MovindiM/Lead-Acid-Battery-Charger/Lead_Acid_Battery_Charger_PCB/Constant_Current/Schematic_Constant-Current_2022-05-03.png

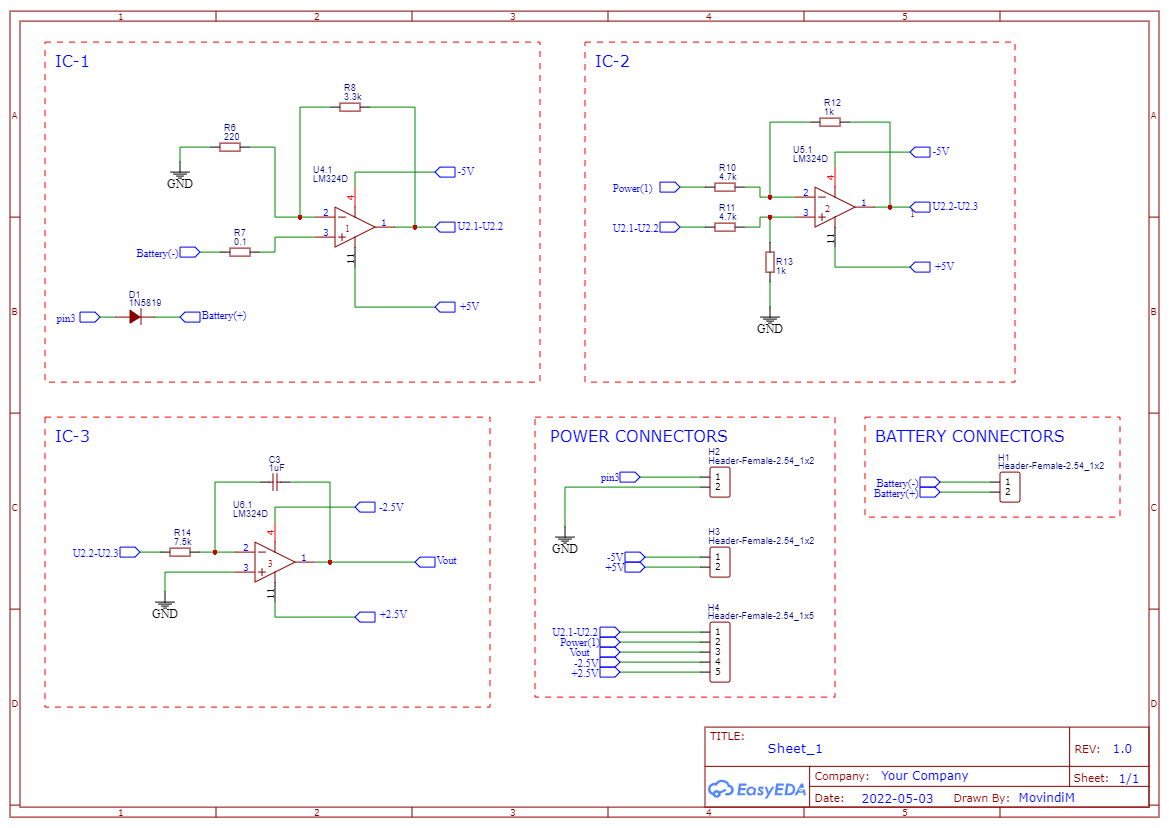
Lead_Acid_Battery_Charger_PCB/Constant_Current/Schematic_Constant-Current_2022-05-03.png
