MovindiM/Lead-Acid-Battery-Charger/Lead_Acid_Battery_Charger_PCB/Constant_Volatage/PCB_PCB_Constant-Voltage_2022-05-03.png

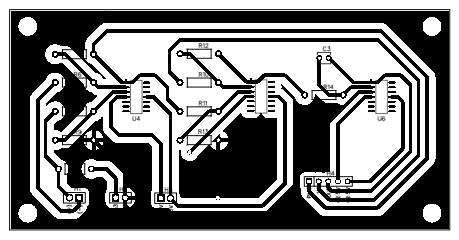
Lead_Acid_Battery_Charger_PCB/Constant_Volatage/PCB_PCB_Constant-Voltage_2022-05-03.png
