MovindiM/Lead-Acid-Battery-Charger/Lead_Acid_Battery_Charger_PCB/PWM/PCB_PCB_PWM_2022-05-03.png

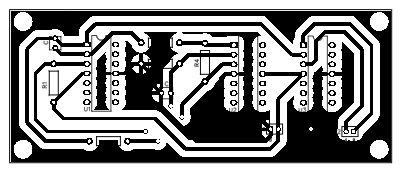
Lead_Acid_Battery_Charger_PCB/PWM/PCB_PCB_PWM_2022-05-03.png
