MovindiM/Lead-Acid-Battery-Charger/Lead_Acid_Battery_Charger_PCB/PWM/Schematic_Semester4-Lab project_2022-05-03.png

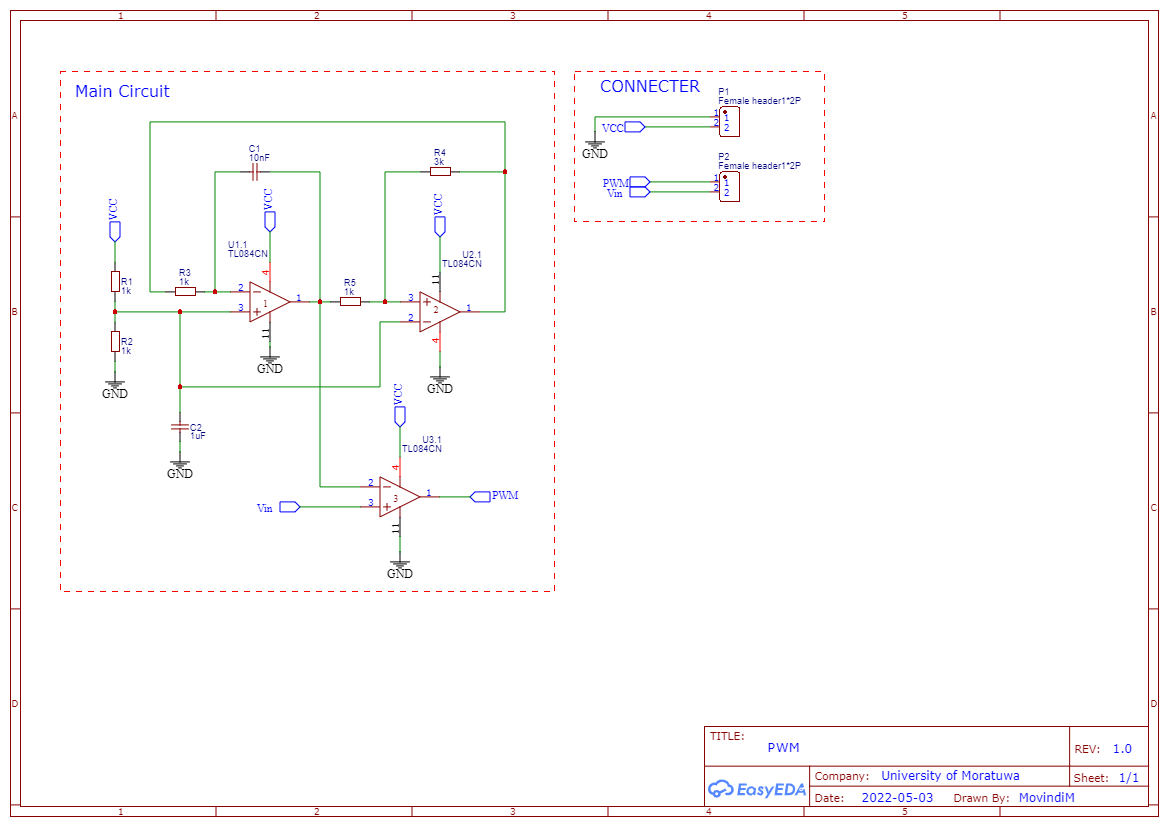
Lead_Acid_Battery_Charger_PCB/PWM/Schematic_Semester4-Lab project_2022-05-03.png
