MovindiM/Lead-Acid-Battery-Charger/Lead_Acid_Battery_Charger_PCB/Smoothing/Schematic_Smoothing_2022-05-04.png

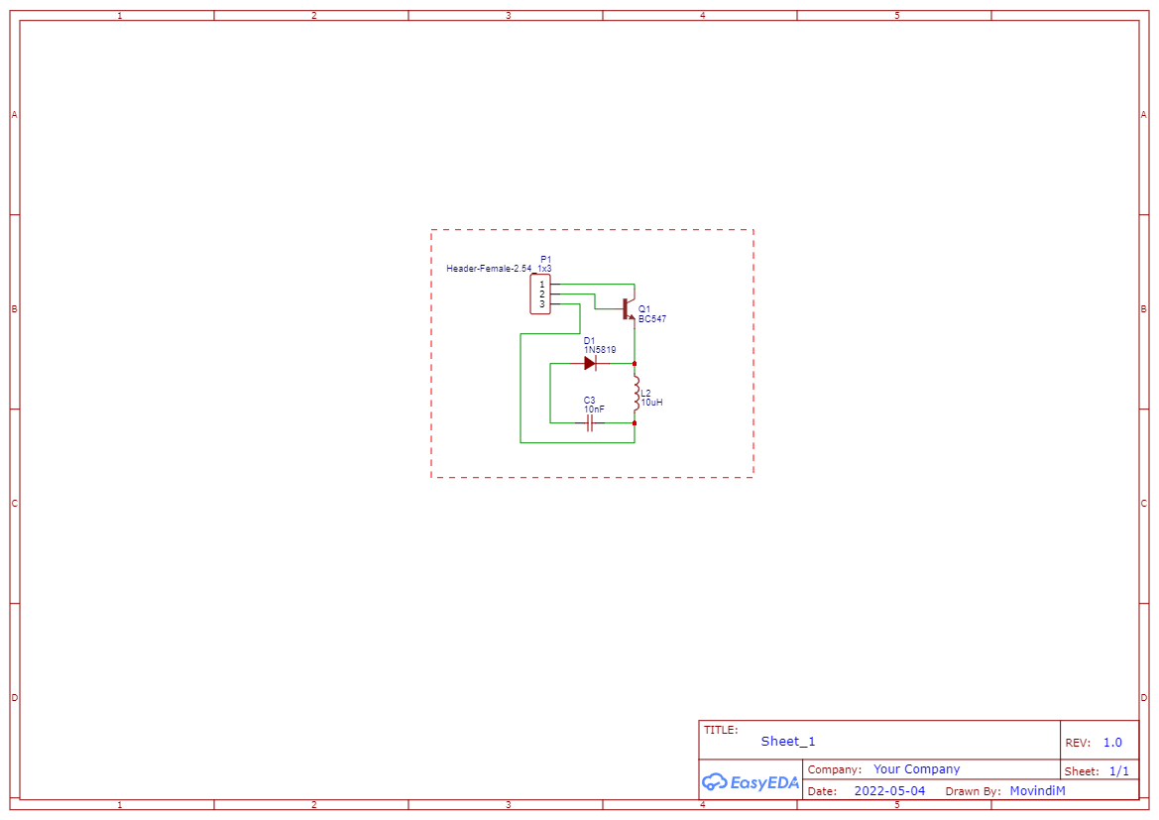
Lead_Acid_Battery_Charger_PCB/Smoothing/Schematic_Smoothing_2022-05-04.png
