MovindiM/Lead-Acid-Battery-Charger/Lead_Acid_Battery_Charger_PCB/PWM/Schematic_Semester4-Lab project_2022-05-03.pdf

Main Circuit | CONNECTER

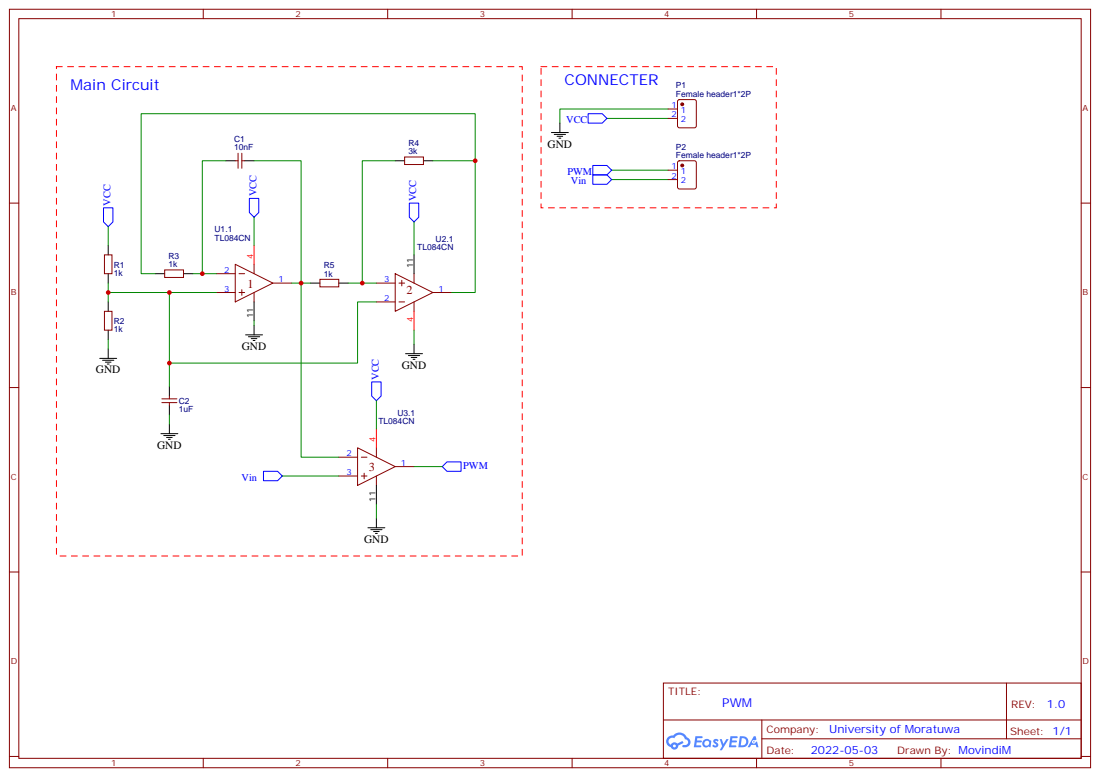
[picture p33: page 1]

Company: University of Moratuwa
