MovindiM/Lead-Acid-Battery-Charger/Lead_Acid_Battery_Charger_PCB/Constant_Current/Schematic_Constant-Current_2022-05-03.pdf

IC-1 | IC-2

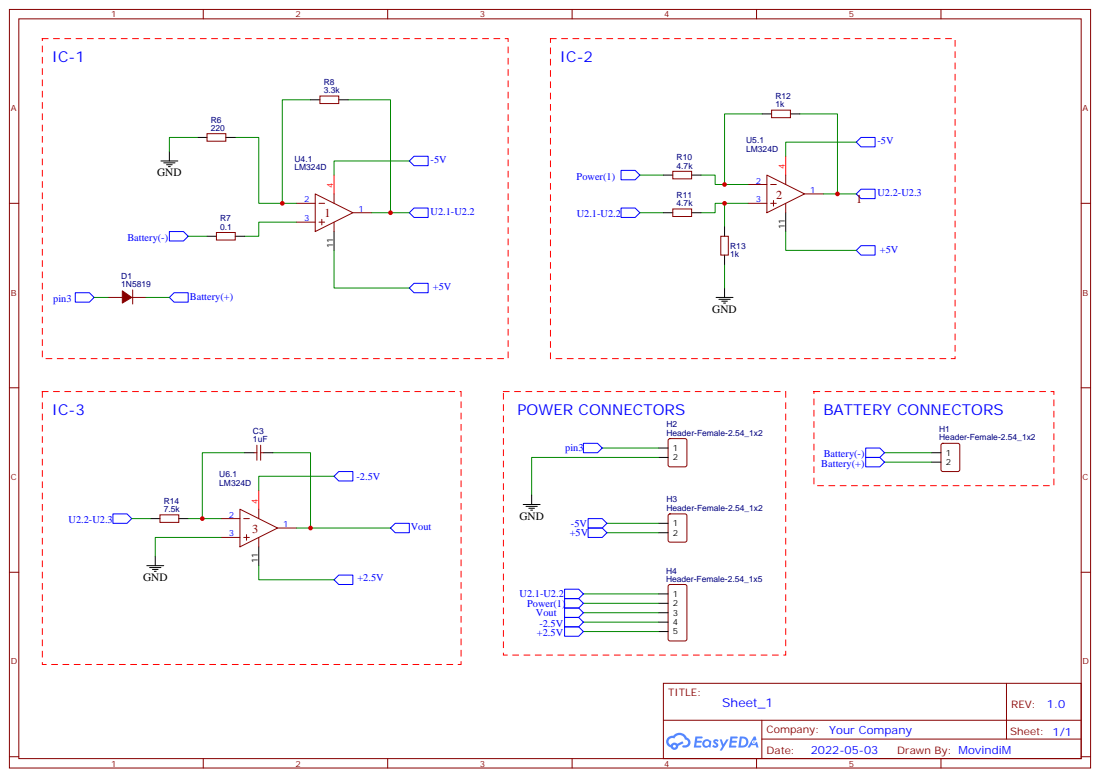
[picture p34: page 1]
