MovindiM/Lead-Acid-Battery-Charger/Lead_Acid_Battery_Charger_PCB/Constant_Volatage/Schematic_Constant-Voltage_2022-05-03.pdf

IC-1 | IC-2

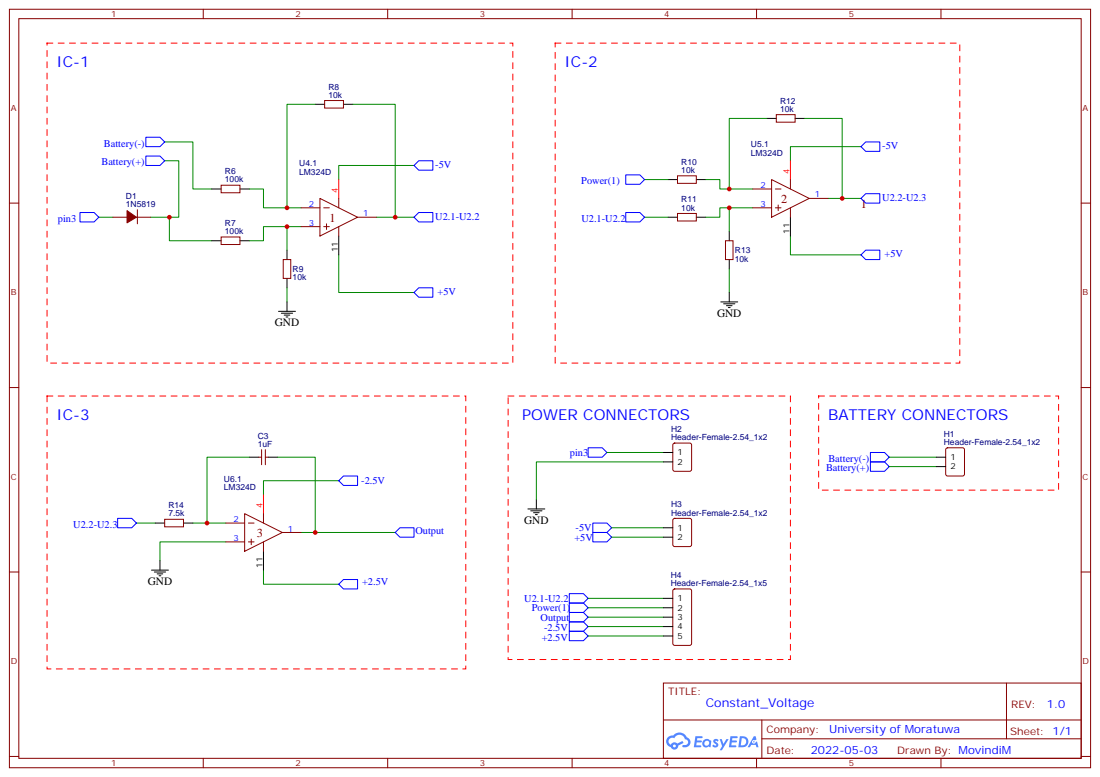
[picture p35: page 1]

Company: University of Moratuwa
