MovindiM/Lead-Acid-Battery-Charger/Lead_Acid_Battery_Charger_PCB/Switching/Schematic_Switching_2022-05-04.pdf

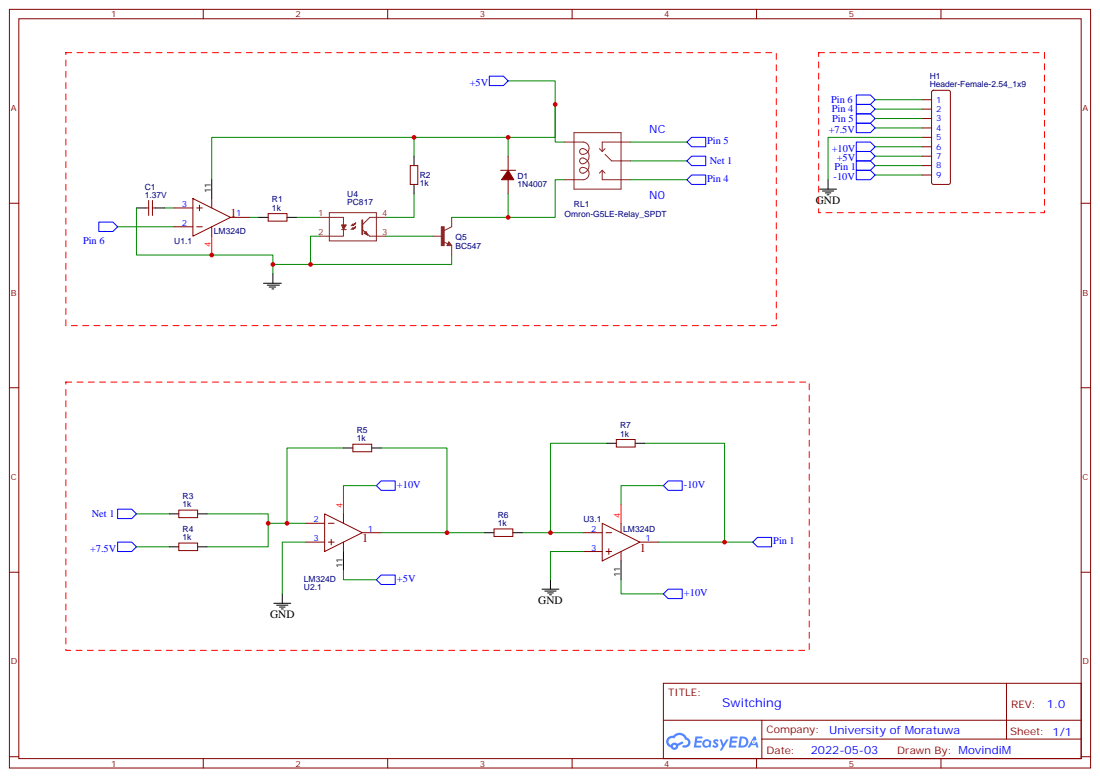
[picture p37: page 1]

Company: University of Moratuwa
