MovindiM/Lead-Acid-Battery-Charger/Lead_Acid_Battery_Charger_PCB/Constant_Current/PCB_PCB_Constant-Current_2022-05-03.pdf

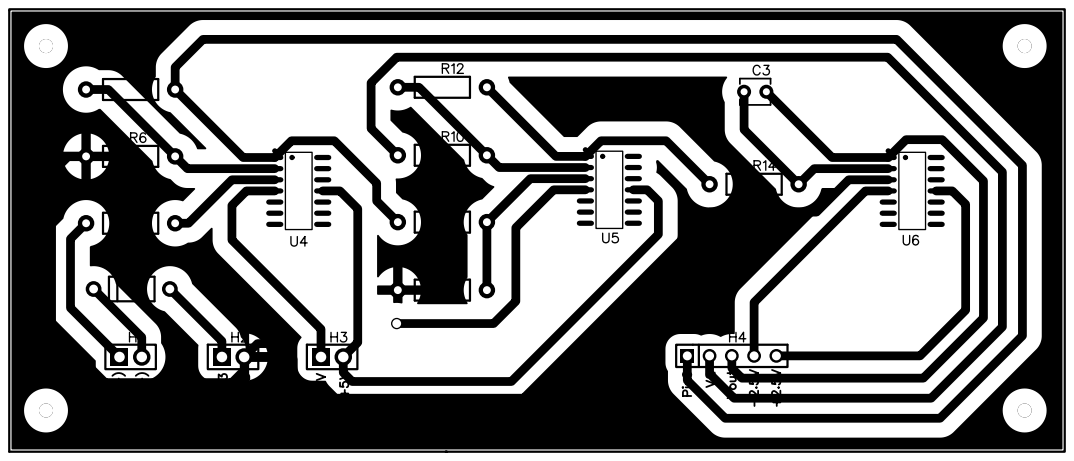
[picture p38: page 1]
