MovindiM/Lead-Acid-Battery-Charger/Lead_Acid_Battery_Charger_PCB/PWM/PCB_PCB_PWM_2022-05-03.pdf

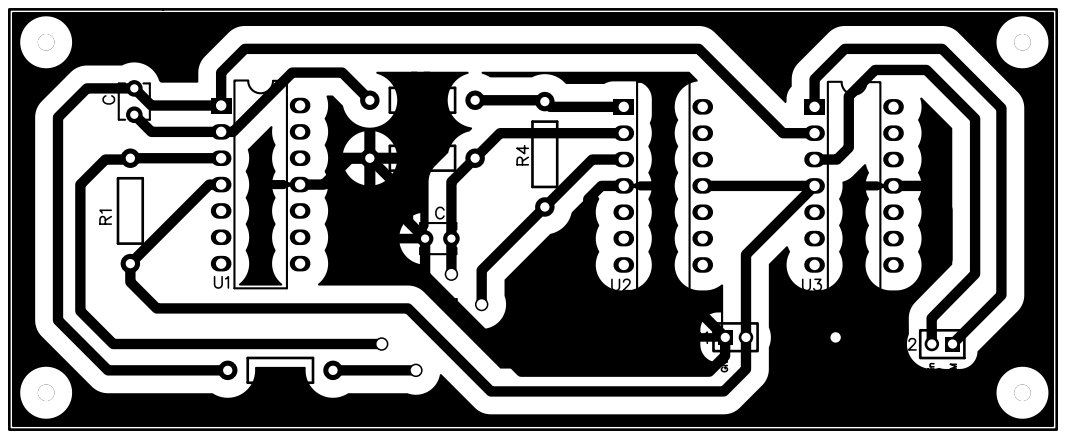
[picture p40: page 1]
