MovindiM/Lead-Acid-Battery-Charger/Lead_Acid_Battery_Charger_PCB/Smoothing/PCB_PCB_Smoothing_2022-05-04.pdf

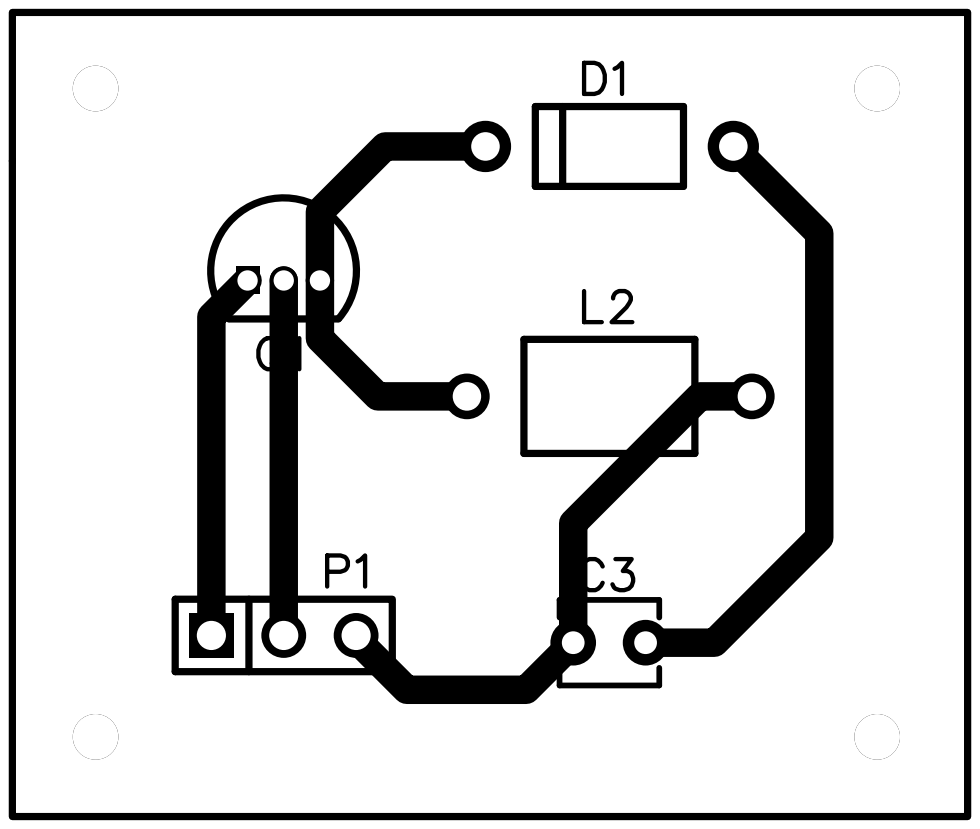
[picture p41: page 1]
