MovindiM/Lead-Acid-Battery-Charger/(list of files, drawings)

Other design files:
Lead_Acid_Battery_Charger_PCB/Constant_Current/Constant_Current_schematic_2022-05-03.schdoc
Lead_Acid_Battery_Charger_PCB/Constant_Current/PCB_Constant-Current_2022-05-03.pcbdoc
Lead_Acid_Battery_Charger_PCB/Constant_Volatage/Constant_Voltage_schematic_2022-05-03.schdoc
Lead_Acid_Battery_Charger_PCB/Constant_Volatage/PCB_Constant-Voltage_2022-05-03.pcbdoc
Lead_Acid_Battery_Charger_PCB/PWM/PCB_PWM_2022-05-03.pcbdoc
Lead_Acid_Battery_Charger_PCB/PWM/PWM_schematic_2022-05-03.schdoc
Lead_Acid_Battery_Charger_PCB/Smoothing/PCB_Smoothing_2022-05-04.pcbdoc
Lead_Acid_Battery_Charger_PCB/Smoothing/Smoothing_shematic_2022-05-04.schdoc
Lead_Acid_Battery_Charger_PCB/Switching/PCB_Switching_2022-05-04.pcbdoc
Lead_Acid_Battery_Charger_PCB/Switching/Switching_schematic_2022-05-04.schdoc
LeadAcid_Battery_Charger_Circuits/CC.ms14
LeadAcid_Battery_Charger_Circuits/CV.ms14
LeadAcid_Battery_Charger_Circuits/PWM and smoothing.ms14
LeadAcid_Battery_Charger_Circuits/PWM.ms14
